timnoot/antenna/README.md

# Satellite Tracker Antenna - LiS

[GitHub](https://github.com/timnoot/antenna) | [Wiki](https://github.com/timnoot/antenna/wiki) | [Website](https://antenna-six.vercel.app/)

Welcome to the Satellite Tracker Antenna project! This project aims to develop an automated antenna system capable of tracking weather (NOAA) satellites and receiving high-quality images from space.

## Open-Source Kit for Students

One of our goals with this project is to make an open-source kit that students can build themselves. This kit will serve as an educational tool, allowing students to learn about satellite technology, engineering, and data processing through hands-on experience.

### Features

- **Automated Tracking**: The antenna system autonomously follows the satellite's trajectory.
- **High-Quality Images**: Capture and process images directly from NOAA satellites.
- **Customizable**: Easily modify and extend the system to suit different needs and preferences.

## Project Highlights

Here's a preview of what our project has achieved so far:

<table style="margin: 0 auto;">
  <tr>
    <td style="padding: 1rem; text-align: center;">
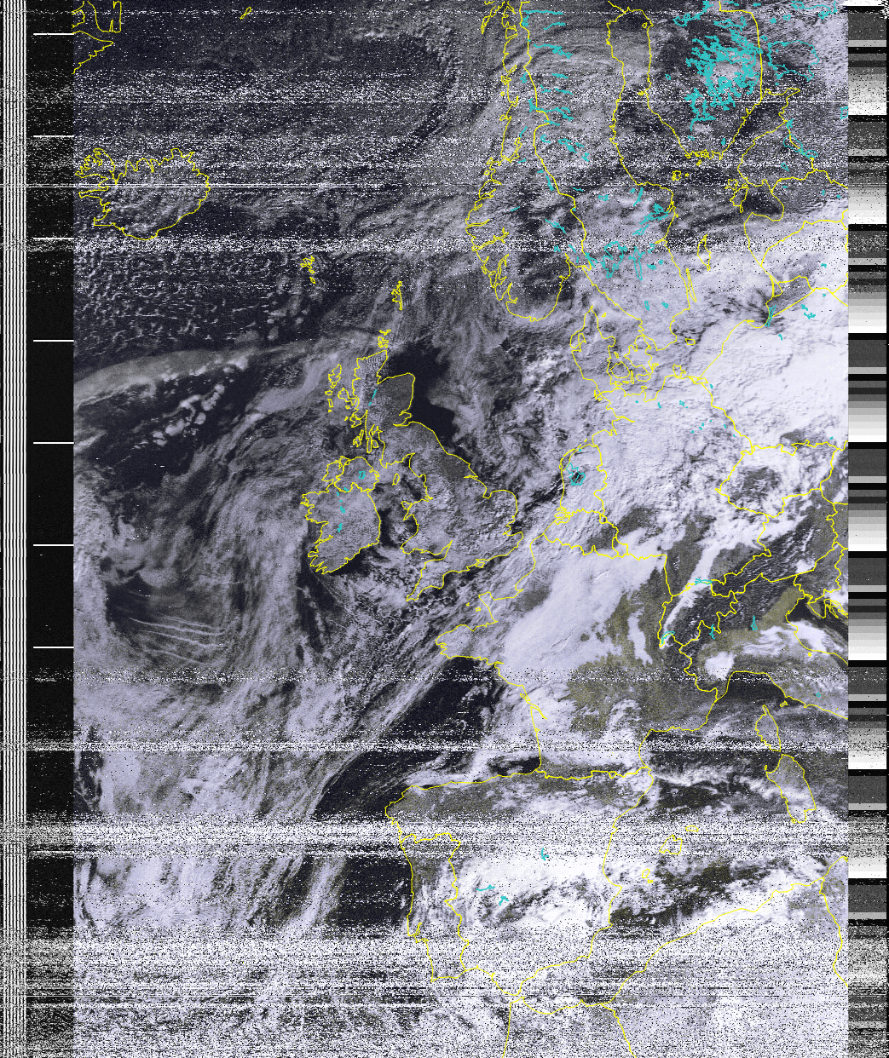
[picture p1: documentation/capture.png]
Captured Image
      
      Captured Image
    </td>
    <td style="padding: 1rem; text-align: center;">
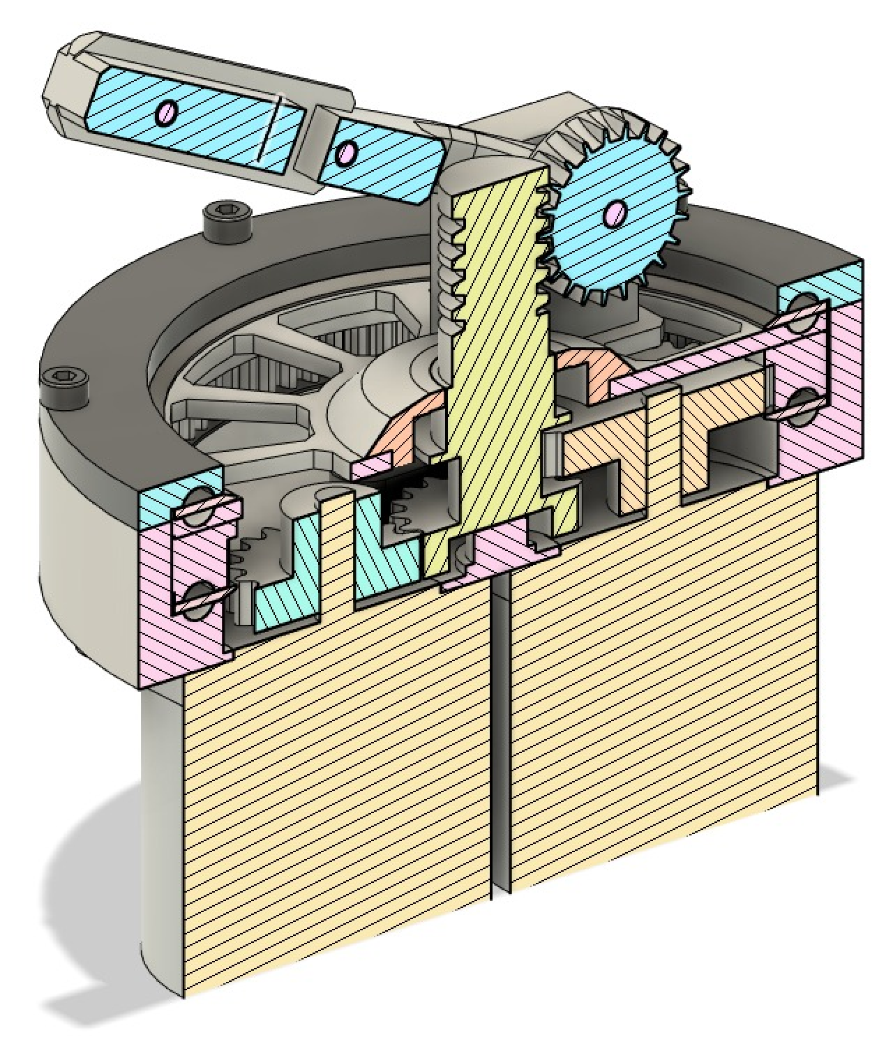
[picture p2: documentation/model.png]
Antenna Model
      
      Antenna Model
    </td>
  </tr>
</table>

## Getting Started

To get started with the project, follow these steps:
1. Check out our [Wiki](https://github.com/timnoot/antenna/wiki)
2. Build the antenna and electronics.
3. Use our [website](https://antenna-six.vercel.app/) to control your antenna.

For detailed instructions, refer to the [Wiki](https://github.com/timnoot/antenna/wiki)

## License

This project is licensed under the MIT License - see the [LICENSE](https://github.com/timnoot/antenna/blob/main/LICENSE) file for details.

## Contact

For questions or suggestions, please open an issue.
