timnoot/antenna/documentation/electricial_diagram.png

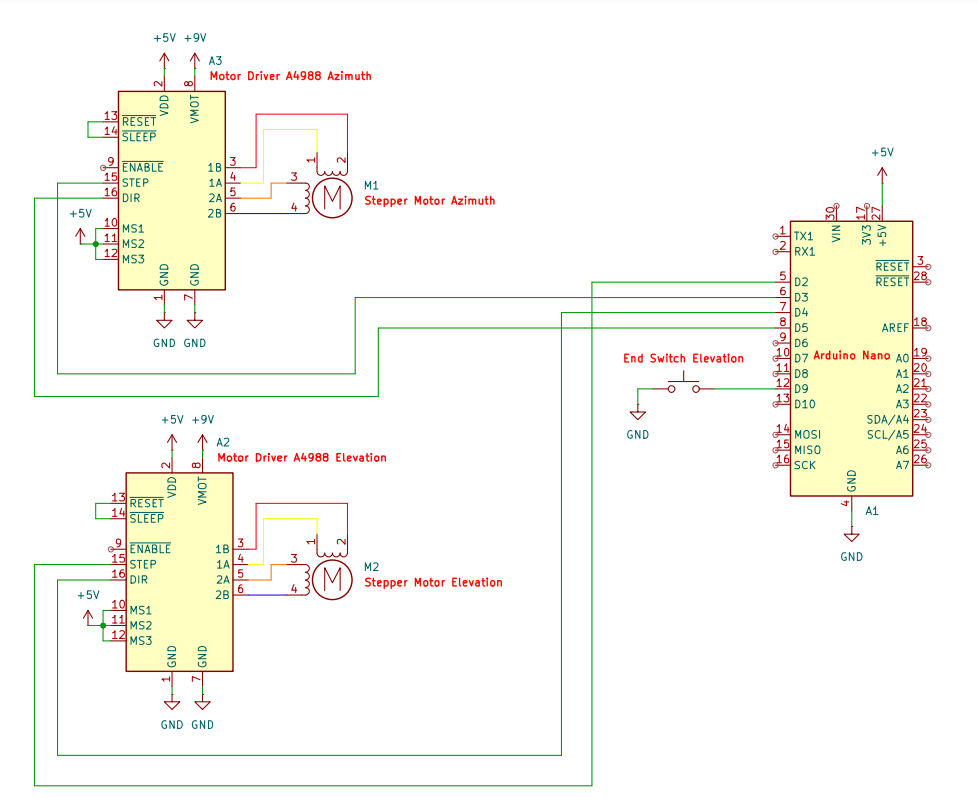
documentation/electricial_diagram.png
