timnoot/antenna/documentation/website_control.png

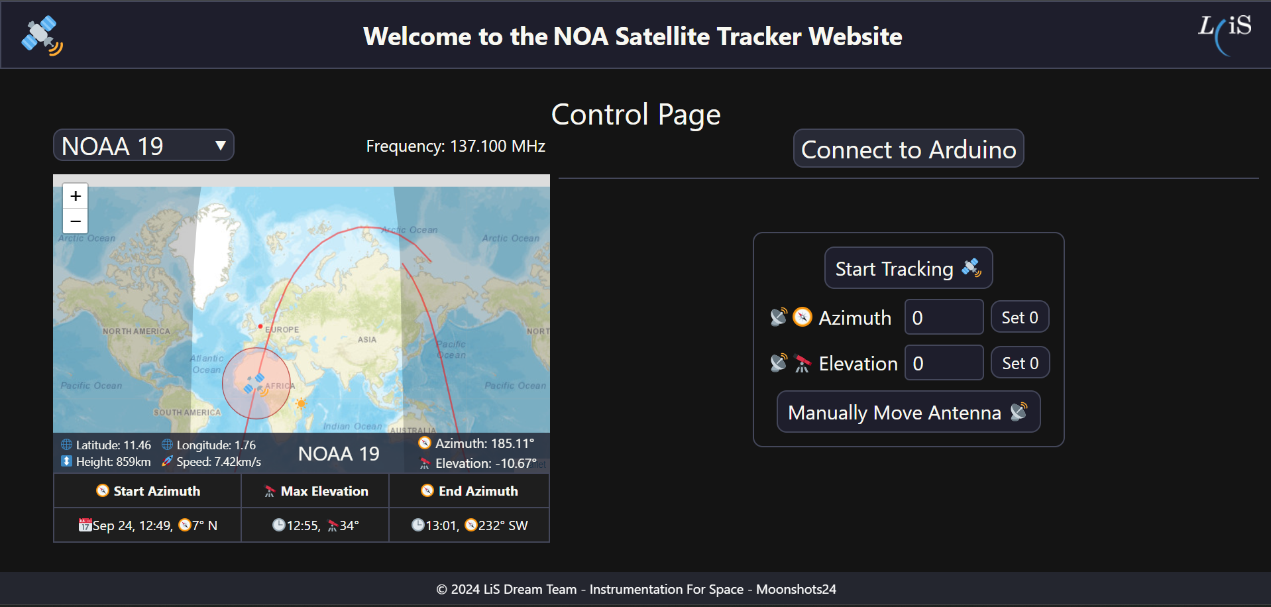
documentation/website_control.png
