timnoot/antenna/3D models/step/Ring.step

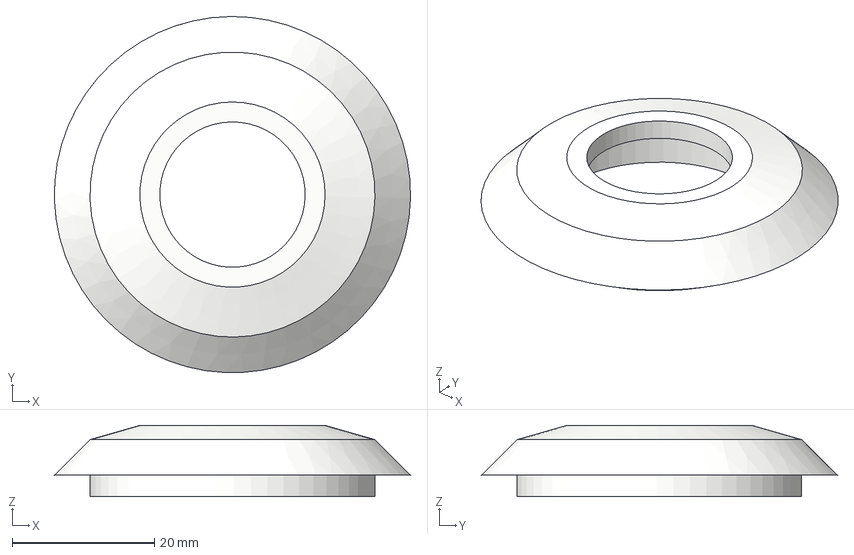
[picture p5: CAD file, 2024-09-26]
3D models/step/Ring.step
50.0 x 50.0 x 10.0 mm
