timnoot/antenna/3D models/step/Wormgear.step

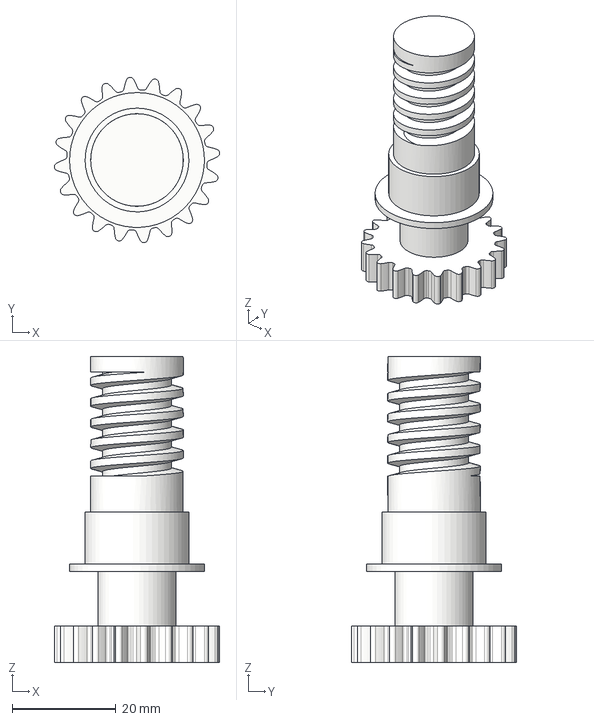
[picture p6: CAD file, 2024-09-26]
3D models/step/Wormgear.step
31.9 x 31.9 x 59.0 mm
