timnoot/antenna/3D models/step/Bearingring.step

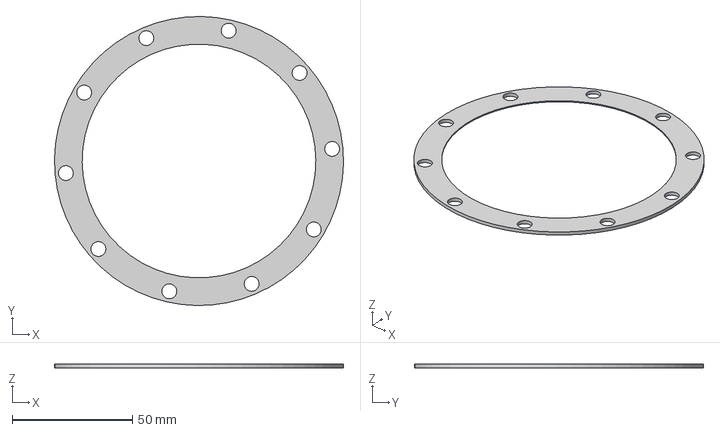
[picture p7: CAD file, 2024-09-26]
3D models/step/Bearingring.step
120.0 x 120.0 x 1.50 mm
Lagerring
Rotatieschijf
