timnoot/antenna/3D models/step/Arm2.step

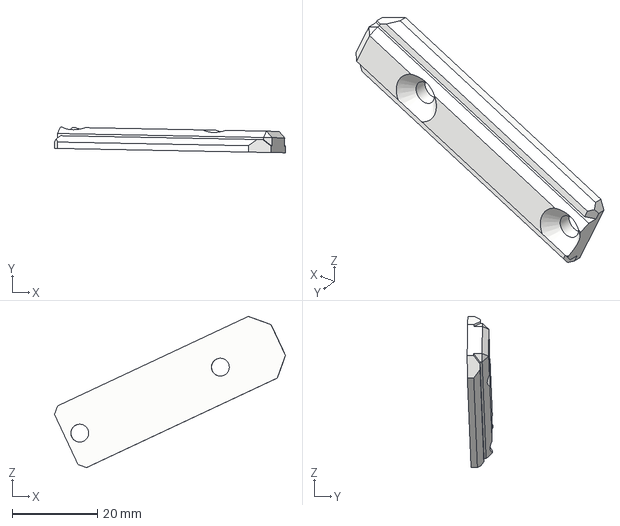
[picture p8: CAD file, 2024-09-26]
3D models/step/Arm2.step
54.3 x 6.02 x 35.5 mm
