timnoot/antenna/3D models/step/Frame.step

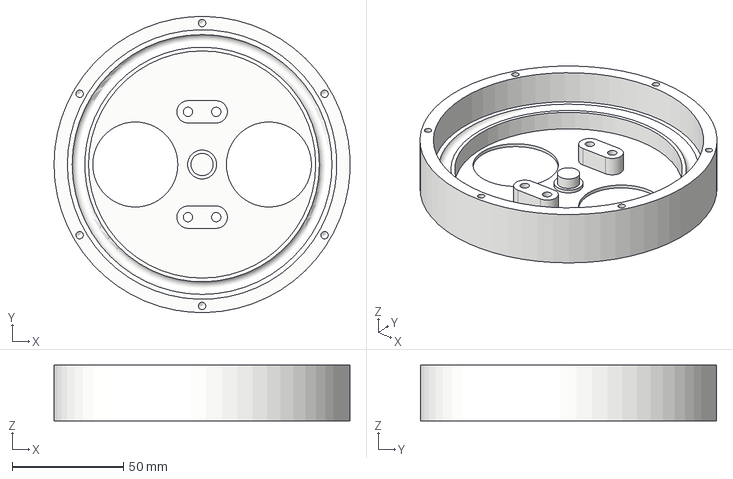
[picture p9: CAD file, 2024-09-26]
3D models/step/Frame.step
132.9 x 133.0 x 25.0 mm
Bevestigingspaneel
Rotatieschijf
