timnoot/antenna/3D models/step/Arm1.step

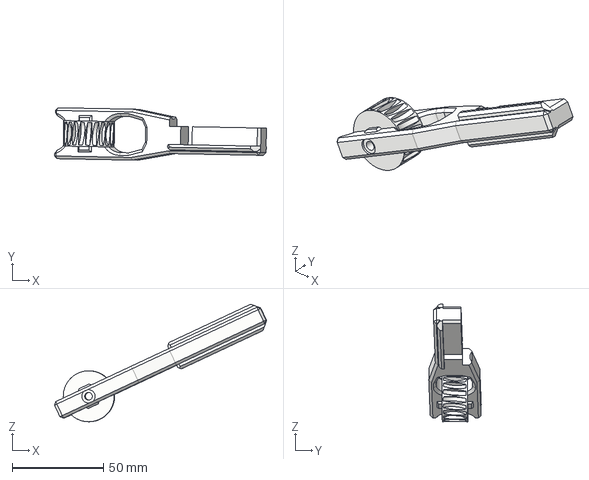
[picture p10: CAD file, 2024-09-26]
3D models/step/Arm1.step
116.5 x 28.9 x 64.6 mm
