timnoot/antenna/3D models/step/Tandwielschijf.step

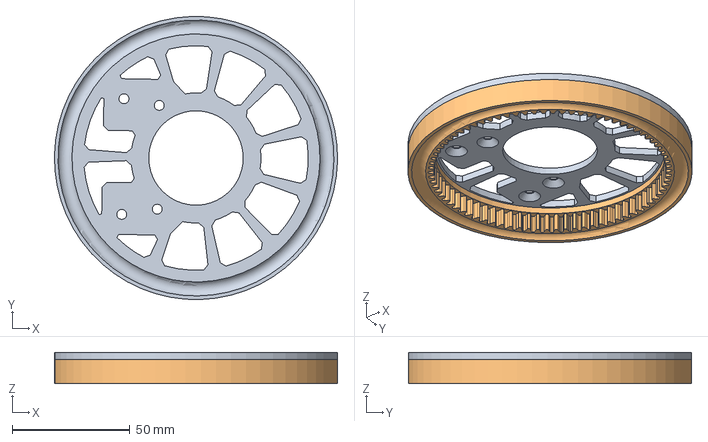
[picture p11: CAD file, 2024-09-26]
3D models/step/Tandwielschijf.step
120.0 x 119.9 x 13.3 mm
