timnoot/antenna/3D models/step/Gear1.step

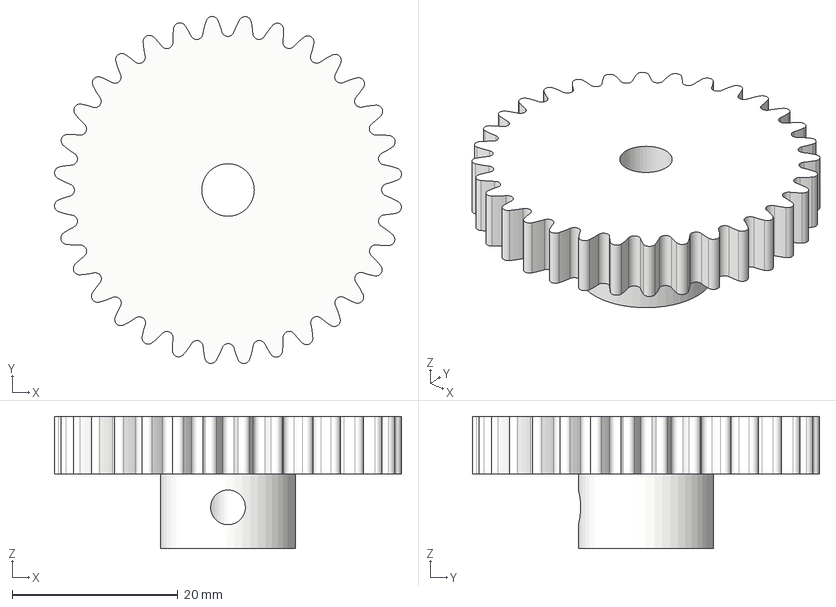
[picture p12: CAD file, 2024-09-26]
3D models/step/Gear1.step
41.9 x 41.9 x 16.0 mm
