timnoot/antenna/3D models/step/Gear2.step

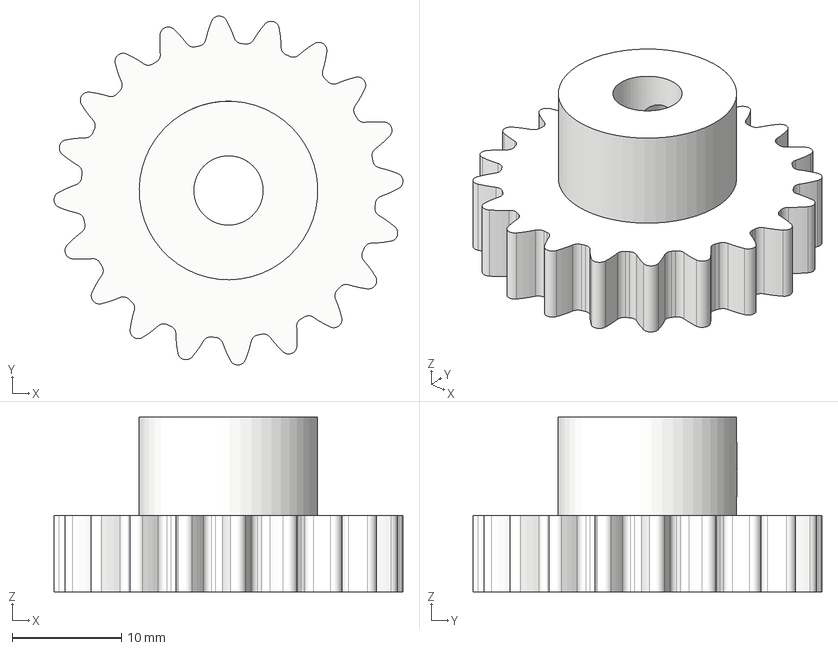
[picture p13: CAD file, 2024-09-26]
3D models/step/Gear2.step
32.0 x 32.0 x 16.0 mm
