timnoot/antenna/3D models/step/Block1.step

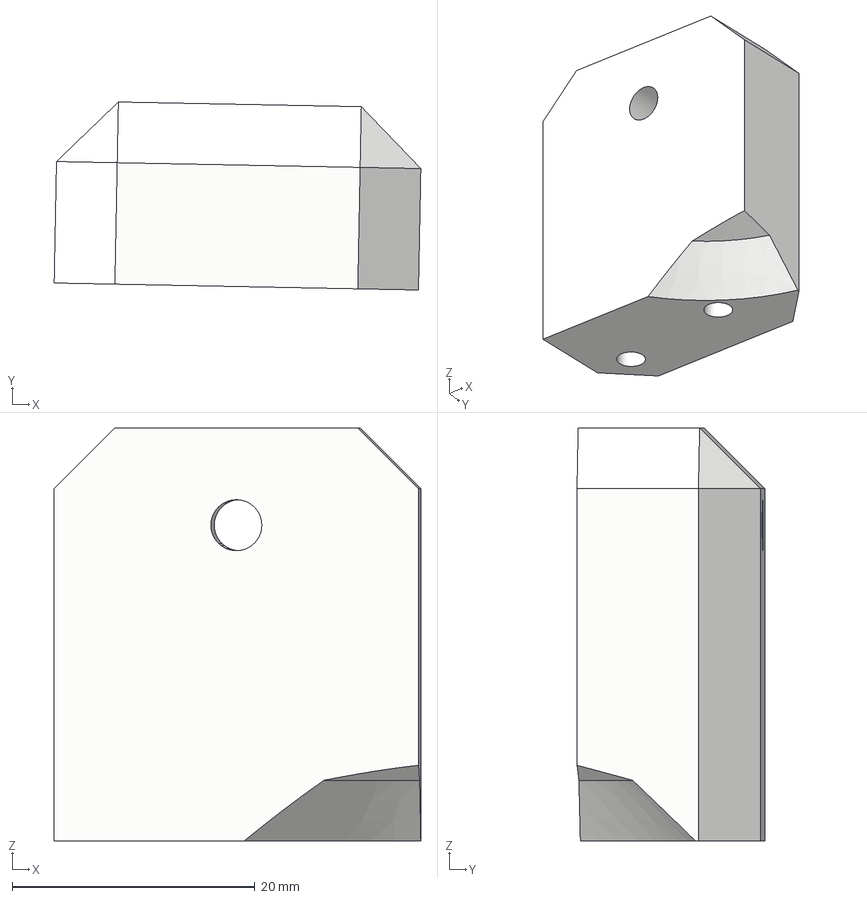
[picture p14: CAD file, 2024-09-26]
3D models/step/Block1.step
30.2 x 15.5 x 34.0 mm
