timnoot/antenna/3D models/step/Coverplate.step

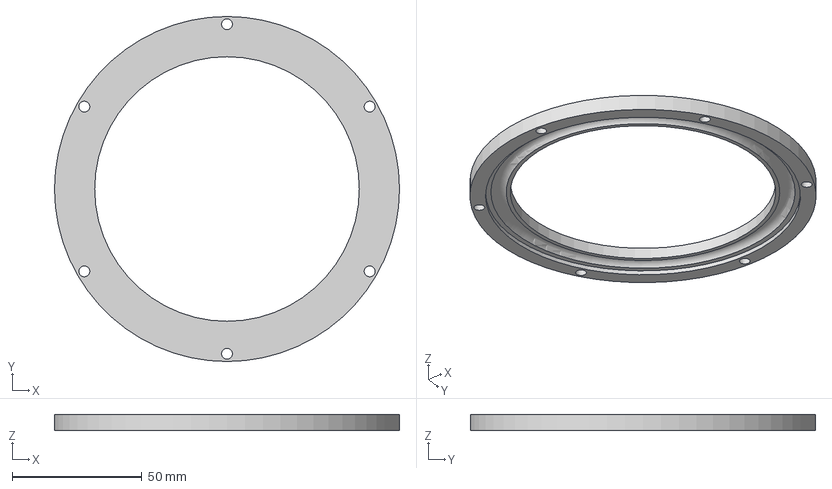
[picture p15: CAD file, 2024-09-26]
3D models/step/Coverplate.step
133.0 x 133.0 x 6.25 mm
Rotatieschijf
5/31/24_3:28_PM
