timnoot/antenna/3D models/step/Stappenmotor.step

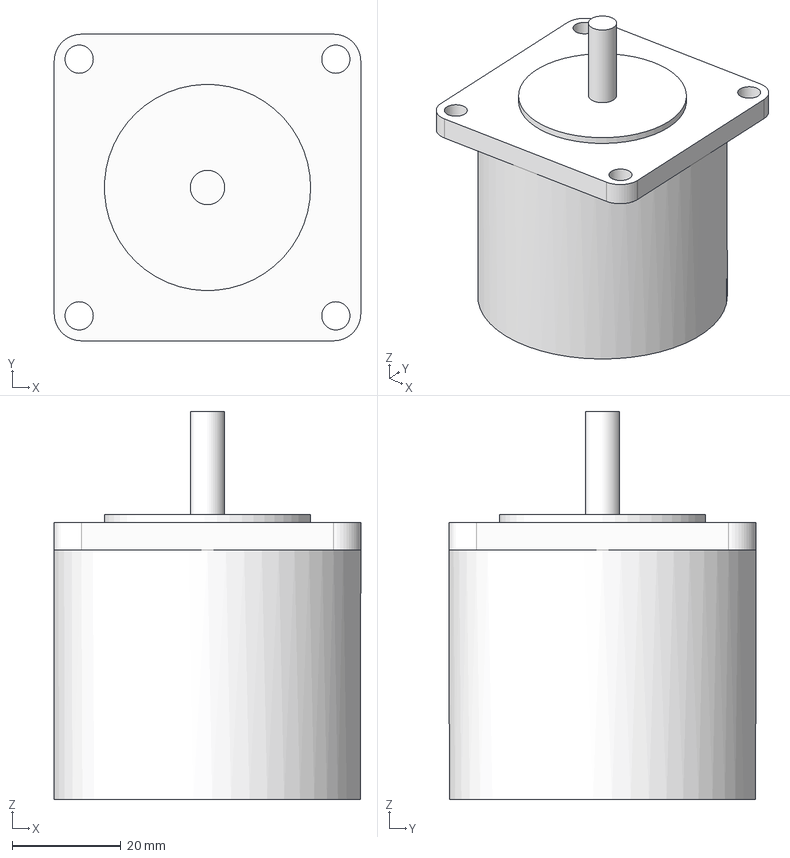
[picture p16: CAD file, 2024-09-26]
3D models/step/Stappenmotor.step
56.5 x 56.5 x 71.5 mm
