timnoot/antenna/(list of files, cad)

Other CAD files:
3D models/step/Block2.step
3D models/stl/Arm1.stl
3D models/stl/Arm2.stl
3D models/stl/Bearingring.stl
3D models/stl/Block1.stl
3D models/stl/Block2.stl
3D models/stl/Coverplate.stl
3D models/stl/Frame.stl
3D models/stl/Gear1.stl
3D models/stl/Gear2.stl
3D models/stl/Ring.stl
3D models/stl/Stappenmotor.stl
3D models/stl/Tandwielschijf.stl
3D models/stl/Wormgear.stl
