timnoot/antenna/documentation/electricial_diagram.pdf

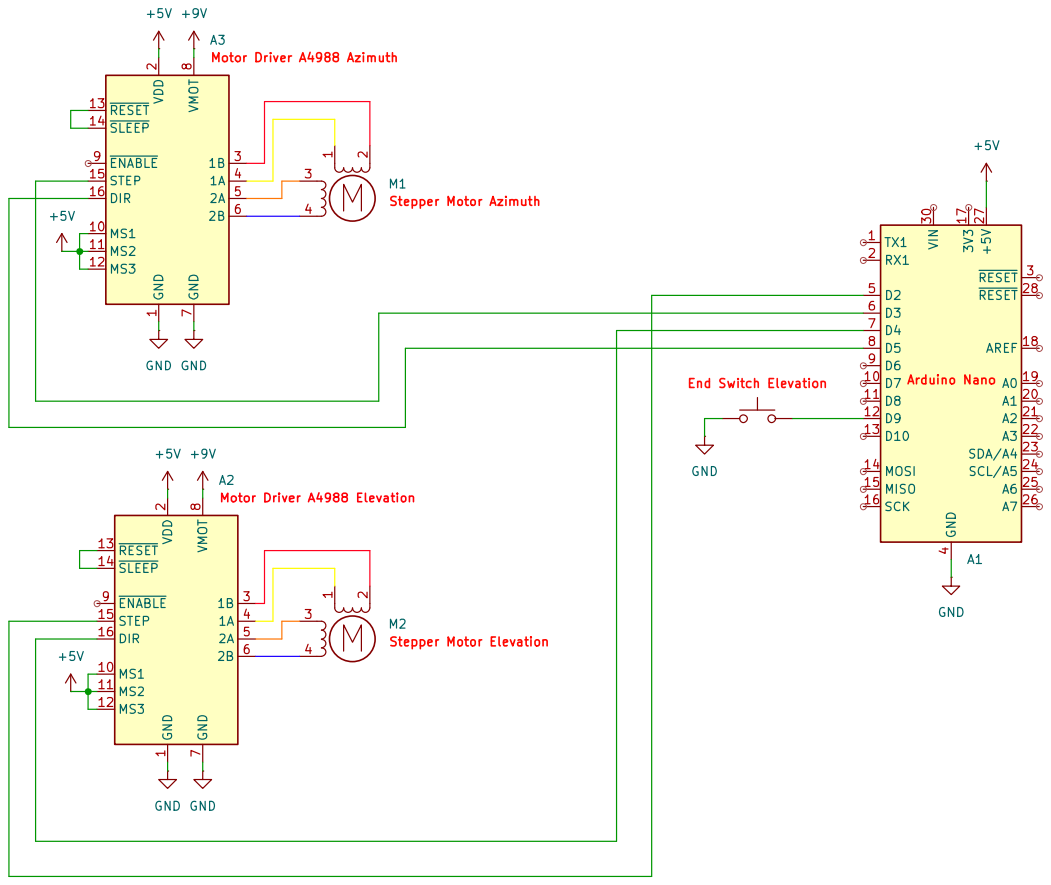
[picture p17: page 1]
