timnoot/antenna/Antenna Python Software/main.py

import time
import aiohttp
import aioserial
import serial.tools.list_ports
import os
from itertools import cycle
import requests
import asyncio
from logging import getLogger
import json

from kivy.app import App
from kivy.uix.button import Button
from kivy.uix.label import Label
from kivy.uix.boxlayout import BoxLayout
from kivy.uix.textinput import TextInput
from kivy.uix.gridlayout import GridLayout
from kivy.uix.dropdown import DropDown
from kivy.uix.popup import Popup

from kivy.core.window import Window

Window.size = (400, 300)

"""
NORAD ID's
----------------
NOAA 19 = 33591 # best
NOAA 18 = 28654 # best
NOAA 17 = 27453

NOAA 15 = 25338
"""

SATELLITES = [
    {"name": "NOAA 19", "norad_id": 33591},
    {"name": "NOAA 18", "norad_id": 28654},
    {"name": "NOAA 17", "norad_id": 27453},
    {"name": "NOAA 15", "norad_id": 25338},
    # {"name": "", "norad_id": 45684},
    {"name": "ISS", "norad_id": 25544},
    {"name": "NOAA 20", "norad_id": 43013},
]


class CustomPopup(Popup):
    def __init__(self, title, message, **kwargs):
        super().__init__(**kwargs)
        self.title = title
        self.size_hint = (None, None)
        self.size = (400, 200)

        self.label = Label(text=message, size_hint=(1, 1))
        self.content = self.label


class SetLatLongPopup(Popup):
    def __init__(self, estimated_lat=0, estimated_long=0, **kwargs):
        super().__init__(**kwargs)
        self.title = "Configure latitude and longitude"
        self.size_hint = (None, None)
        self.size = (450, 250)

        self.layout = BoxLayout(orientation='vertical', padding=10, spacing=10, size_hint=(None, None), size=(400, 400))

        # Input layout
        input_layout = GridLayout(cols=2, spacing=10, size_hint_y=None)
        input_layout.bind(minimum_height=input_layout.setter('height'))

        self.latitude_input = TextInput(
            hint_text='Enter latitude', multiline=False, size_hint=(None, None), size=(180, 40), input_filter='float',
            text=str(estimated_lat) if estimated_lat else ""
        )
        input_layout.add_widget(Label(text="Latitude"))
        input_layout.add_widget(self.latitude_input)

        self.longitude_input = TextInput(
            hint_text='Enter longitude', multiline=False, size_hint=(None, None), size=(180, 40), input_filter='float',
            text=str(estimated_long) if estimated_long else ""
        )
        input_layout.add_widget(Label(text="Longitude"))
        input_layout.add_widget(self.longitude_input)

        self.layout.add_widget(input_layout)

        # Button to set latitude and longitude
        set_button = Button(text='Set', size_hint_y=None, height=40, background_color=(0, 0.7, 0.7, 1))
        set_button.bind(on_press=self.set_lat_long)
        self.layout.add_widget(set_button)

        self.content = self.layout

    def set_lat_long(self, instance):
        try:
            lat = float(self.latitude_input.text)
            long = float(self.longitude_input.text)
        except ValueError:
            CustomPopup(title="Error", message="Latitude and longitude must be floats").open()
            return

        with open("settings.json", "w") as f:
            json.dump({
                "LATITUDE": lat,
                "LONGITUDE": long
            }, f)

        self.dismiss()


class Client(App):
    API_KEYS = cycle([
        "CKN6RH-VHFY63-3CWULX-59R0",
        "8HB8G9-HQZ5J3-XXPTVU-58JL",
        "P2N6P2-CPVNLR-F7R727-59R1"
    ])

    PORTS = [port.device for port in serial.tools.list_ports.comports()]
    COM_PORT = PORTS[0] if len(PORTS) == 1 else None

    other_task = None

    """
    OP codes
    ----------------
    0 = position
    1 = set azimuth 0
    2 = set elevation 0
    3 = move azimuth and elevation to x
    4 = find zero position
    """

    def __init__(self, _loop=None):
        super(Client, self).__init__()
        self.arduino: aioserial.AioSerial = None
        self.session: aiohttp.ClientSession = None
        self.loop: asyncio.AbstractEventLoop = _loop
        self.logger = getLogger('kivy')

        with open("settings.json", "r") as f:
            settings = json.load(f)
            self.LATITUDE = settings["LATITUDE"]
            self.LONGITUDE = settings["LONGITUDE"]

        self.NORAD_ID = None

        self.send_position = False
        self.azimuth = 0
        self.elevation = 0

        # UI elements
        self.layout = None

        self.azimuth_input = None
        self.elevation_input = None
        self.azimuth_label = None
        self.elevation_label = None

        self.dropdown1 = None
        self.tracking_button = None

    async def init(self):
        try:
            self.arduino = aioserial.AioSerial(port=self.COM_PORT, baudrate=9600)
        except Exception as e:
            self.logger.error(e)
            self.logger.error("Arduino not found")
        try:
            self.session = aiohttp.ClientSession()
        except Exception as e:
            self.logger.error(e)
            self.logger.error("Session not created")

    def update_coordinates(self):
        self.azimuth_label.text = f'Azimuth: {self.azimuth}'
        self.elevation_label.text = f'Elevation: {self.elevation}'

    def on_position_send_button(self, instance):
        if self.COM_PORT is None or self.NORAD_ID is None:
            CustomPopup(title="Error", message="Select COM port and satellite first").open()
            self.logger.error("Select COM port and satellite first")
            return

        self.send_position = not self.send_position
        # change the color of the button
        if self.send_position:
            self.tracking_button.background_color = (1, 0, 0, 1)
            self.tracking_button.text = "Stop sending position"
        else:
            self.tracking_button.background_color = (0, 1, 0, 1)
            self.tracking_button.text = "Start sending position"

    def select_satellite(self, instance):
        for satellite in SATELLITES:
            if satellite["name"] == instance.text:
                self.NORAD_ID = satellite["norad_id"]
                break

    def move_antenna(self, instance):
        # get the azimuth and elevation from the input fields
        try:
            temp_az = int(self.azimuth_input.text)
            temp_el = int(self.elevation_input.text)
        except ValueError:
            CustomPopup(title="Error", message="Azimuth and elevation must be integers").open()
            self.logger.error("Azimuth and elevation must be integers")
            return

        self.azimuth = temp_az
        self.elevation = temp_el

        self.update_coordinates()

        # send the data to the arduino
        asyncio.ensure_future(self.write_arduino({
            "op": "3",
            "az": self.azimuth,
            "el": self.elevation
        }))

    def azimuth_set_0(self, instance):
        self.azimuth = 0
        asyncio.ensure_future(self.write_arduino({
            "op": "1"
        }))
        self.azimuth_input.text = "0"
        self.update_coordinates()

    def elevation_set_0(self, instance):
        self.elevation = 0
        asyncio.ensure_future(self.write_arduino({
            "op": "2"
        }))
        self.elevation_input.text = "0"
        self.update_coordinates()

    def find_zero_position(self, instance):
        asyncio.ensure_future(self.write_arduino({
            "op": "4"
        }))
        CustomPopup(title="Zero position", message="Finding zero position").open()
        self.elevation = 0
        self.elevation_input.text = "0"
        self.update_coordinates()

    def select_com_port(self, instance):
        for port in self.PORTS:
            if port == instance.text:
                self.arduino.close()

                self.COM_PORT = port
                try:
                    self.arduino = aioserial.AioSerial(port=self.COM_PORT, baudrate=9600)
                except Exception as e:
                    self.logger.error(f"Arduino not found {e}")
                    CustomPopup(title="Error", message="Arduino not found").open()
                    self.COM_PORT = None
                    return
                self.logger.info(f"Selected port: {self.COM_PORT}")
                break

    def update_comports(self):
        self.PORTS = [port.device for port in serial.tools.list_ports.comports()]
        if len(self.PORTS) == 0:
            CustomPopup(title="Error", message="No serial ports found").open()
            self.logger.error("No serial ports found")
            self.COM_PORT = None

        # update the dropdown in the layout
        self.dropdown1.clear_widgets()
        for port in self.PORTS:
            btn = Button(text=port, size_hint_y=None, height=40, background_color=(1, 1, 1, 1))
            btn.bind(on_release=lambda btn: self.dropdown1.select(btn.text))
            btn.bind(on_release=self.select_com_port)
            self.dropdown1.add_widget(btn)

    def build(self):
        self.title = 'Antenna Tracking Software LiS - v1.0'
        self.icon = 'icon.png'

        self.layout = BoxLayout(orientation='vertical', padding=10, spacing=10, size_hint=(None, None), size=(500, 400))

        # Show serial ports
        input_layout = GridLayout(cols=2, spacing=10, size_hint_y=None)
        input_layout.bind(minimum_height=input_layout.setter('height'))

        com_port_label = Label(text=f'Select COM port', size_hint=(None, None), size=(200, 40), halign='right')
        input_layout.add_widget(com_port_label)

        r = [port.device for port in serial.tools.list_ports.comports()]

        self.dropdown1 = DropDown()
        for port in r:
            btn = Button(text=port, size_hint_y=None, height=40, background_color=(1, 1, 1, 1))
            btn.bind(on_release=lambda btn: self.dropdown1.select(btn.text))
            btn.bind(on_release=self.select_com_port)
            self.dropdown1.add_widget(btn)

        select_port_button = Button(text=self.COM_PORT if self.COM_PORT else "Select port", size_hint_y=None, height=40,
                                    background_color=(0, 0.7, 0.7, 1))
        # select_port_button.bind(on_release=lambda btn: dropdown1.open(select_port_button))
        # first run the update_comports function and then open the dropdown
        select_port_button.bind(
            on_release=lambda btn: [self.update_comports(), self.dropdown1.open(select_port_button)])

        self.dropdown1.bind(on_select=lambda instance, x: setattr(select_port_button, 'text', x))
        input_layout.add_widget(select_port_button)

        self.layout.add_widget(input_layout)

        # Button to find zero point
        zero_button = Button(text='Find zero point', size_hint_y=None, height=40, background_color=(1, 1, 0, 1))
        zero_button.bind(on_press=self.find_zero_position)
        self.layout.add_widget(zero_button)

        # Dropdown for selecting satellites
        dropdown = DropDown()
        for satellite in SATELLITES:
            btn = Button(text=satellite["name"], size_hint_y=None, height=40, background_color=(1, 1, 1, 1))
            btn.bind(on_release=lambda btn: dropdown.select(btn.text))
            btn.bind(on_release=self.select_satellite)
            dropdown.add_widget(btn)

        select_satellite_button = Button(text='Select Satellite', size_hint_y=None, height=40,
                                         background_color=(0, 0.7, 0.7, 1))
        select_satellite_button.bind(on_release=dropdown.open)
        dropdown.bind(on_select=lambda instance, x: setattr(select_satellite_button, 'text', x))
        self.layout.add_widget(select_satellite_button)

        # Button to send position
        self.tracking_button = Button(text='Start sending position', size_hint_y=None, height=40,
                                      background_color=(0, 1, 0, 1))
        self.tracking_button.bind(on_press=self.on_position_send_button)
        self.layout.add_widget(self.tracking_button)

        # Input layout
        input_layout = GridLayout(cols=3, spacing=10, size_hint_y=None)
        input_layout.bind(minimum_height=input_layout.setter('height'))

        self.azimuth_label = Label(text=f'Azimuth: {self.azimuth}', size_hint=(None, None), size=(120, 40),
                                   halign='right')
        input_layout.add_widget(self.azimuth_label)
        # make it 0 by default
        self.azimuth_input = TextInput(hint_text='Enter azimuth', multiline=False, size_hint=(None, None),
                                       size=(200, 40), input_filter='int', text='0')
        input_layout.add_widget(self.azimuth_input)

        azimuth_set_0_button = Button(text='Set 0', size_hint_y=None, height=40, background_color=(1, 1, 1, 1))
        azimuth_set_0_button.bind(on_press=self.azimuth_set_0)
        input_layout.add_widget(azimuth_set_0_button)

        self.elevation_label = Label(text=f'Elevation: {self.elevation}', size_hint=(None, None), size=(120, 40),
                                     halign='right')
        input_layout.add_widget(self.elevation_label)
        self.elevation_input = TextInput(hint_text='Enter elevation', multiline=False, size_hint=(None, None),
                                         size=(200, 40), input_filter='int', text='0')
        input_layout.add_widget(self.elevation_input)

        elevation_set_0_button = Button(text='Set 0', size_hint_y=None, height=40, background_color=(1, 1, 1, 1))
        elevation_set_0_button.bind(on_press=self.elevation_set_0)
        input_layout.add_widget(elevation_set_0_button)

        self.layout.add_widget(input_layout)

        # Button to move antenna
        move_button = Button(text='Move antenna', size_hint_y=None, height=40, background_color=(0, 0.7, 0.7, 1))
        move_button.bind(on_press=self.move_antenna)
        self.layout.add_widget(move_button)

        return self.layout

    async def get_satellite_location(self, norad_id, latitude, longitude) -> dict:
        async with self.session.get(
                f"https://api.n2yo.com/rest/v1/satellite/positions/{norad_id}/{latitude}/{longitude}/0/2/?apiKey={next(self.API_KEYS)}"
        ) as response:
            res = await response.json()
            """
            azimuth = Degrees from north
            elevation = Degrees up from ground
            https://www.celestis.com/media/3811/az_elevation.jpg
            """
            azimuth = res["positions"][0]["azimuth"]
            elevation = res["positions"][0]["elevation"]
            self.logger.info(f'{res["info"]["satname"]} - az={azimuth}°, el={elevation}°')

            return {
                "op": "0",
                "sa": res["info"]["satname"],
                "az": azimuth,
                "el": elevation
            }

    async def get_estimated_lat_long(self):
        async with self.session.get("https://ipapi.co/json") as response:
            res = await response.json()
            return res["latitude"], res["longitude"]

    async def write_arduino(self, x):
        try:
            await self.arduino.write_async(self.to_arduino_format(x).encode())
        except Exception as e:
            self.logger.error(e)
            self.logger.error("Arduino not found")
            # put a popup ontop
            CustomPopup(title="Error", message="Arduino not found").open()

    @staticmethod
    def to_arduino_format(json_data):
        str1 = ""
        for key, value in json_data.items():
            str1 += f"{key}:{value};"
        return str1

    async def main(self):
        self.logger.info("Starting main")
        await self.init()
        start = time.time()

        if self.LATITUDE is None or self.LONGITUDE is None:
            await asyncio.sleep(0.1)
            lat, long = await self.get_estimated_lat_long()
            SetLatLongPopup(lat, long).open()

        while True:
            if time.time() - start > 1 and self.send_position:
                start = time.time()

                r = await self.get_satellite_location(self.NORAD_ID, self.LATITUDE, self.LONGITUDE)
                if r["el"] < -5:
                    CustomPopup(title="Error", message=f"Elevation is too low\naz={r['az']}°, el={r['el']}°").open()
                    self.logger.error("Elevation is too low")
                    self.send_position = False
                    self.tracking_button.background_color = (0, 1, 0, 1)
                    self.tracking_button.text = "Start sending position"
                    continue

                await self.write_arduino(r)

                self.azimuth = r["az"]
                self.elevation = r["el"]

                self.update_coordinates()

            await asyncio.sleep(0.1)

    def startup(self):
        """This will run both methods asynchronously and then block until they
        are finished
        """
        self.other_task = asyncio.ensure_future(self.main())

        async def run_wrapper():
            # we don't actually need to set asyncio as the lib because it is
            # the default, but it doesn't hurt to be explicit
            await self.async_run(async_lib='asyncio')
            print('App done')
            self.other_task.cancel()

        return asyncio.gather(run_wrapper(), self.other_task)


if __name__ == '__main__':
    if not os.path.exists("icon.png"):  # check if icon.png exists
        print("icon.png not found downloading from github")
        r = requests.get("https://raw.githubusercontent.com/timnoot/antenna/main/Antenna%20Python%20Software/icon.png")
        with open("icon.png", "wb") as f:
            f.write(r.content)

    if not os.path.exists("settings.json"):
        with open("settings.json", "w") as f:
            json.dump({
                "LATITUDE": None,
                "LONGITUDE": None
            }, f)

    try:
        loop = asyncio.get_event_loop()
        loop.run_until_complete(Client(loop).startup())
        loop.close()
    except (KeyboardInterrupt, SystemExit):
        pass
    except Exception as e:
        print("Error", e)
