timnoot/antenna/(commit log)

2024-04-17 update gear ratio
2024-04-17 track sattelite
2024-06-28 Added better scaling for bigger devices
2024-09-24 added electricial_diagram
    [electricial_diagram.kicad_sch]
2024-09-26 move step and stl into seperate folders
    [Arm1.step, Arm1.stl, Arm2.step, Arm2.stl, Bearingring.step, Bearingring.stl, Block1.step, Block1.stl]
